keyandcableco/pr53_emu/captures/mapping.csv

bit | direction | label | A_l1 | A_l2 | B_l1 | B_l2 | A_ms | B_ms
C3:r3:c3 | ON | chord_root_C | ConcertGrand | 8 Beat | ConcertGrand | 8 Beat | 1469929982 | 1469985329
C3:r3:c4 | ON | chord_root_C | ConcertGrand | 8 Beat | ConcertGrand | 8 Beat | 1469929982 | 1469985329
C3:r0:c2 | OFF | chord_root_C | ConcertGrand | 8 Beat | ConcertGrand | 8 Beat | 1469929982 | 1469985329
C3:r1:c2 | OFF | chord_root_C | ConcertGrand | 8 Beat | ConcertGrand | 8 Beat | 1469929982 | 1469985329
C3:r1:c3 | OFF | chord_root_C | ConcertGrand | 8 Beat | ConcertGrand | 8 Beat | 1469929982 | 1469985329
C3:r1:c4 | OFF | chord_root_C | ConcertGrand | 8 Beat | ConcertGrand | 8 Beat | 1469929982 | 1469985329
C3:r4:c2 | OFF | chord_root_C | ConcertGrand | 8 Beat | ConcertGrand | 8 Beat | 1469929982 | 1469985329
C3:r4:c3 | OFF | chord_root_C | ConcertGrand | 8 Beat | ConcertGrand | 8 Beat | 1469929982 | 1469985329
C3:r4:c4 | OFF | chord_root_C | ConcertGrand | 8 Beat | ConcertGrand | 8 Beat | 1469929982 | 1469985329
C3:r7:c2 | OFF | chord_root_C | ConcertGrand | 8 Beat | ConcertGrand | 8 Beat | 1469929982 | 1469985329
C5:r0:c0 | ON | chord_root_C | ConcertGrand | 8 Beat | ConcertGrand | 8 Beat | 1470096539 | 1470109558
C5:r2:c0 | ON | chord_root_C | ConcertGrand | 8 Beat | ConcertGrand | 8 Beat | 1470096539 | 1470109558
C1:r7:c0 | ON | chord_root_C# | ConcertGrand | 8 Beat | ConcertGrand | 8 Beat | 1470109558 | 1470118982
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
C4:r4:c2 | OFF | rhythm_groups_gospel_blues | RHYTHM | Funk | RHYTHM | ChapelGospel | 1470387159 | 1470396660
C4:r4:c3 | OFF | rhythm_groups_gospel_blues | RHYTHM | Funk | RHYTHM | ChapelGospel | 1470387159 | 1470396660
C4:r4:c4 | OFF | rhythm_groups_gospel_blues | RHYTHM | Funk | RHYTHM | ChapelGospel | 1470387159 | 1470396660
C5:r0:c1 | OFF | rhythm_groups_gospel_blues | RHYTHM | Funk | RHYTHM | ChapelGospel | 1470387159 | 1470396660
C5:r0:c2 | OFF | rhythm_groups_gospel_blues | RHYTHM | Funk | RHYTHM | ChapelGospel | 1470387159 | 1470396660
C5:r1:c1 | OFF | rhythm_groups_gospel_blues | RHYTHM | Funk | RHYTHM | ChapelGospel | 1470387159 | 1470396660
C5:r1:c2 | OFF | rhythm_groups_gospel_blues | RHYTHM | Funk | RHYTHM | ChapelGospel | 1470387159 | 1470396660
C5:r2:c2 | OFF | rhythm_groups_gospel_blues | RHYTHM | Funk | RHYTHM | ChapelGospel | 1470387159 | 1470396660
C5:r3:c1 | OFF | rhythm_groups_gospel_blues | RHYTHM | Funk | RHYTHM | ChapelGospel | 1470387159 | 1470396660
C5:r3:c2 | OFF | rhythm_groups_gospel_blues | RHYTHM | Funk | RHYTHM | ChapelGospel | 1470387159 | 1470396660
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
