keyandcableco/pr53_emu/hardware/carrier/pr53_carrier.kicad_pcb

## KiCad design hardware/carrier/pr53_carrier.kicad_pcb (2026-10-31)

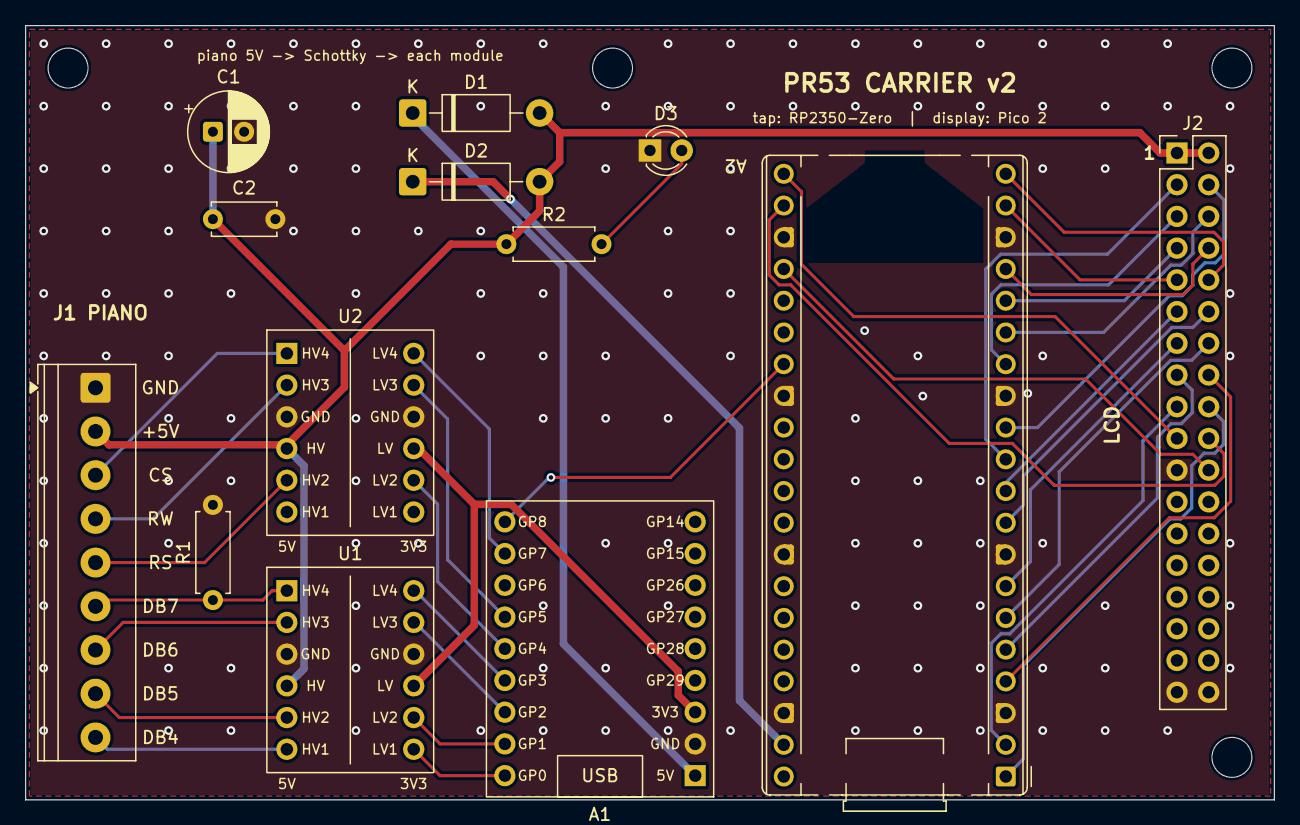
[picture p8: board pr53_carrier.kicad_pcb from above]

Board: 2 copper layers, 100.0 x 62.0 mm, 17 parts (0 on the bottom side), 40 nets.

Parts:
A1: RP2350-Zero (tap); RP2350-Zero_Socket
A2: Pico 2 (display); RaspberryPi_Pico_Common_THT
C1: 100u 10V; CP_Radial_D6.3mm_P2.50mm
C2: 100n; C_Disc_D5.0mm_W2.5mm_P5.00mm
D1, D2: 1N5819; D_DO-41_SOD81_P10.16mm_Horizontal
D3: PWR; LED_D3.0mm
H1, H2, H3, H4: M3; MountingHole_3.2mm_M3
J1: PR53_IN; TerminalBlock_Phoenix_PT-1,5-9-3.5-H_1x09_P3.50mm_Horizontal
J2: LCD_OUT (HiLetgo 36p); PinHeader_2x18_P2.54mm_Vertical
R1: 10k; R_Axial_DIN0207_L6.3mm_D2.5mm_P7.62mm_Horizontal
R2: 1k; R_Axial_DIN0207_L6.3mm_D2.5mm_P7.62mm_Horizontal
U1: BSS138_4ch (DB4-7); BSS138_4ch_Module
U2: BSS138_4ch (RS/RW/CS); BSS138_4ch_Module

Connections:
+3V3_TAP: A1.3, U1.4, U2.4
+5V: C1.1, C2.1, D1.2, D2.2, J1.2, J2.1, J2.2, R2.1, U1.10, U2.10
+5V_DISP: A2.39, D2.1
+5V_TAP: A1.1, D1.1
CS: J1.3, U2.7
DB4: J1.9, U1.12
DB5: J1.8, U1.11
DB6: J1.7, U1.8
DB7: J1.6, R1.1, U1.7
GND: A1.2, A2.3, A2.8, A2.13, A2.18, A2.23, A2.28, A2.33, A2.38, C1.2, C2.2, D3.1, J1.1, J2.21, J2.35, J2.36, R1.2, U1.3, U1.9, U2.3, U2.9
LCD_DB0: A2.1, J2.18
LCD_DB1: A2.2, J2.17
LCD_DB2: A2.4, J2.16
LCD_DB3: A2.5, J2.15
LCD_DB4: A2.6, J2.14
LCD_DB5: A2.7, J2.13
LCD_DB6: A2.9, J2.12
LCD_DB7: A2.10, J2.11
LCD_DB8: A2.11, J2.3
LCD_DB9: A2.12, J2.4
LCD_DB10: A2.14, J2.5
LCD_DB11: A2.15, J2.6
LCD_DB12: A2.16, J2.7
LCD_DB13: A2.17, J2.8
LCD_DB14: A2.19, J2.9
LCD_DB15: A2.20, J2.10
LCD_RS: A2.21, J2.19
LCD_RST: A2.24, J2.22
LCD_WR: A2.22, J2.20
LED_A: D3.2, R2.2
LINK: A1.18, A2.27
RS: J1.5, U2.11
RW: J1.4, U2.8
T_CS: A1.17, U2.1
T_DB4: A1.10, U1.6
T_DB5: A1.11, U1.5
T_DB6: A1.12, U1.2
T_DB7: A1.13, U1.1
T_RS: A1.14, U2.5
T_RW: A1.15, U2.2
