keyandcableco/pr53_emu/firmware/display/src/pr53_font.c

// pr53_font.c — 5x7 bitmap font + primitives, drawn via ili9488_fill_rect.
//
// A compact ASCII subset covers the labels, digits, and symbols the glass
// needs. Special codes: \x01 = quarter note, \x02 = down arrow.

#include "pr53_font.h"
#include "pr53_ili9486_par.h"
#include <string.h>

// 5x7 font, 5 columns per glyph, each column a 7-bit mask (LSB = top row).
// Only the characters we use are populated; others render blank.
typedef struct { char c; uint8_t col[5]; } Glyph;

static const Glyph FONT[] = {
    {' ', {0,0,0,0,0}},
    {'-', {0x08,0x08,0x08,0x08,0x08}},
    {'#', {0x14,0x7F,0x14,0x7F,0x14}},
    {'/', {0x60,0x10,0x08,0x04,0x03}},
    {'&', {0x36,0x49,0x55,0x22,0x50}},
    {'=', {0x14,0x14,0x14,0x14,0x14}},
    {'.', {0x00,0x60,0x60,0x00,0x00}},
    {'0', {0x3E,0x51,0x49,0x45,0x3E}},
    {'1', {0x00,0x42,0x7F,0x40,0x00}},
    {'2', {0x42,0x61,0x51,0x49,0x46}},
    {'3', {0x21,0x41,0x45,0x4B,0x31}},
    {'4', {0x18,0x14,0x12,0x7F,0x10}},
    {'5', {0x27,0x45,0x45,0x45,0x39}},
    {'6', {0x3C,0x4A,0x49,0x49,0x30}},
    {'7', {0x01,0x71,0x09,0x05,0x03}},
    {'8', {0x36,0x49,0x49,0x49,0x36}},
    {'9', {0x06,0x49,0x49,0x29,0x1E}},
    {'A', {0x7E,0x11,0x11,0x11,0x7E}},
    {'B', {0x7F,0x49,0x49,0x49,0x36}},
    {'C', {0x3E,0x41,0x41,0x41,0x22}},
    {'D', {0x7F,0x41,0x41,0x22,0x1C}},
    {'E', {0x7F,0x49,0x49,0x49,0x41}},
    {'F', {0x7F,0x09,0x09,0x09,0x01}},
    {'G', {0x3E,0x41,0x49,0x49,0x7A}},
    {'H', {0x7F,0x08,0x08,0x08,0x7F}},
    {'I', {0x00,0x41,0x7F,0x41,0x00}},
    {'J', {0x20,0x40,0x41,0x3F,0x01}},
    {'K', {0x7F,0x08,0x14,0x22,0x41}},
    {'L', {0x7F,0x40,0x40,0x40,0x40}},
    {'M', {0x7F,0x02,0x0C,0x02,0x7F}},
    {'N', {0x7F,0x04,0x08,0x10,0x7F}},
    {'O', {0x3E,0x41,0x41,0x41,0x3E}},
    {'P', {0x7F,0x09,0x09,0x09,0x06}},
    {'Q', {0x3E,0x41,0x51,0x21,0x5E}},
    {'R', {0x7F,0x09,0x19,0x29,0x46}},
    {'S', {0x46,0x49,0x49,0x49,0x31}},
    {'T', {0x01,0x01,0x7F,0x01,0x01}},
    {'U', {0x3F,0x40,0x40,0x40,0x3F}},
    {'V', {0x1F,0x20,0x40,0x20,0x1F}},
    {'W', {0x7F,0x20,0x18,0x20,0x7F}},
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
    // lowercase (full set for voice/rhythm names)
    {'a', {0x20,0x54,0x54,0x54,0x78}},
    {'b', {0x7F,0x48,0x44,0x44,0x38}},
    {'c', {0x38,0x44,0x44,0x44,0x20}},
    {'d', {0x38,0x44,0x44,0x48,0x7F}},
    {'e', {0x38,0x54,0x54,0x54,0x18}},
    {'f', {0x08,0x7E,0x09,0x01,0x02}},
    {'g', {0x0C,0x52,0x52,0x52,0x3E}},
    {'h', {0x7F,0x08,0x04,0x04,0x78}},
    {'i', {0x00,0x44,0x7D,0x40,0x00}},
    {'j', {0x20,0x40,0x44,0x3D,0x00}},
    {'k', {0x7F,0x10,0x28,0x44,0x00}},
    {'l', {0x00,0x41,0x7F,0x40,0x00}},
    {'m', {0x7C,0x04,0x18,0x04,0x78}},
    {'n', {0x7C,0x08,0x04,0x04,0x78}},
    {'o', {0x38,0x44,0x44,0x44,0x38}},
    {'p', {0x7C,0x14,0x14,0x14,0x08}},
    {'q', {0x08,0x14,0x14,0x18,0x7C}},
    {'r', {0x7C,0x08,0x04,0x04,0x08}},
    {'s', {0x48,0x54,0x54,0x54,0x20}},
    {'t', {0x04,0x3F,0x44,0x40,0x20}},
    {'u', {0x3C,0x40,0x40,0x20,0x7C}},
    {'v', {0x1C,0x20,0x40,0x20,0x1C}},
    {'w', {0x3C,0x40,0x30,0x40,0x3C}},
    {'x', {0x44,0x28,0x10,0x28,0x44}},
    {'y', {0x0C,0x50,0x50,0x50,0x3C}},
    {'z', {0x44,0x64,0x54,0x4C,0x44}},
    // symbols
    {'\x01', {0x08,0x7C,0x08,0x00,0x00}},  // quarter note (approx)
    {'\x02', {0x04,0x02,0x7F,0x02,0x04}},  // down arrow (approx)
};

static const Glyph *find_glyph(char c) {
    for (size_t i = 0; i < sizeof(FONT)/sizeof(FONT[0]); i++)
        if (FONT[i].c == c) return &FONT[i];
    return &FONT[0]; // space
}

static int glyph_w(int scale) { return (5 + 1) * scale; } // 5 cols + 1 space

static void draw_glyph(int x, int y, const Glyph *g, int scale, uint16_t color) {
    for (int cx = 0; cx < 5; cx++) {
        uint8_t colbits = g->col[cx];
        for (int ry = 0; ry < 7; ry++) {
            if (colbits & (1 << ry)) {
                ili9488_fill_rect(x + cx*scale, y + ry*scale, scale, scale, color);
            }
        }
    }
}

void font_text(int x, int y, const char *s, int scale, uint16_t color) {
    int cx = x;
    for (; *s; s++) {
        draw_glyph(cx, y, find_glyph(*s), scale, color);
        cx += glyph_w(scale);
    }
}

// Same layout as font_text, but each pixel is a separate dot with a 1 px gap,
// like the original LCD's dot-matrix characters. scale must be 2 or more.
void font_text_dots(int x, int y, const char *s, int scale, uint16_t color) {
    int cx = x;
    for (; *s; s++) {
        const Glyph *g = find_glyph(*s);
        for (int col = 0; col < 5; col++)
            for (int ry = 0; ry < 7; ry++)
                if (g->col[col] & (1 << ry))
                    ili9488_fill_rect(cx + col*scale, y + ry*scale, scale - 1, scale - 1, color);
        cx += glyph_w(scale);
    }
}

static int text_px_w(const char *s, int scale) {
    return (int)strlen(s) * glyph_w(scale);
}

void font_text_centered(int cx, int y, const char *s, int scale, uint16_t color) {
    font_text(cx - text_px_w(s, scale)/2, y, s, scale, color);
}

void font_itoa(char *buf, int v) {
    if (v == 0) { buf[0] = '0'; buf[1] = 0; return; }
    char tmp[12]; int n = 0, neg = 0;
    if (v < 0) { neg = 1; v = -v; }
    while (v) { tmp[n++] = '0' + v % 10; v /= 10; }
    int i = 0;
    if (neg) buf[i++] = '-';
    while (n) buf[i++] = tmp[--n];
    buf[i] = 0;
}

void font_box(int x, int y, int w, int h, uint16_t color) {
    ili9488_fill_rect(x, y, w, 1, color);
    ili9488_fill_rect(x, y + h - 1, w, 1, color);
    ili9488_fill_rect(x, y, 1, h, color);
    ili9488_fill_rect(x + w - 1, y, 1, h, color);
}

void font_kbd_icon(int x, int y, uint16_t color) {
    // a keyboard: outline, white-key dividers, short black keys
    font_box(x, y, 30, 18, color);
    for (int i = 1; i < 5; i++)
        ili9488_fill_rect(x + i*6, y, 1, 18, color);
    for (int i = 0; i < 5; i++)
        if (i != 2) ili9488_fill_rect(x + 4 + i*6, y + 1, 3, 9, color);
}

void font_drum_icon(int x, int y, uint16_t color) {
    // a drum kit: bass drum, two cymbals on stands, a snare
    font_box(x + 6, y + 8, 14, 10, color);              // bass drum
    ili9488_fill_rect(x + 11, y + 11, 4, 4, color);
    ili9488_fill_rect(x, y + 3, 8, 1, color);            // left cymbal + stand
    ili9488_fill_rect(x + 3, y + 3, 1, 15, color);
    ili9488_fill_rect(x + 19, y + 1, 8, 1, color);       // right cymbal + stand
    ili9488_fill_rect(x + 23, y + 1, 1, 17, color);
    font_box(x + 1, y + 10, 5, 4, color);                // snare
}
