keyandcableco/pr53_emu/(commit log)

2026-07-31 Initial commit: SX-PR53 LCD emulator
    [capture.csv, mapping.csv, tempo_learned.csv]
2026-08-01 Major updates, display working 80%
    [mapping.csv, tempo_learned.csv]
2026-10-07 PR53 display firmware: the C port on a Pico 2 driving a 3.5" panel
    pr53_fw is the Python display emulator ported to C for an RP2350, drawing
    the PR53's display on a HiLetgo 3.5" ILI9486/ILI9488 16-bit parallel panel.
    Core 0 decodes the HD44780 accesses, core 1 renders three zones with
    per-field dirty tracking. The bus arrives from the existing v15 tap Pico
    over a one-way UART link (bus_tap.c). host.mk builds the decode and render
    logic on a PC and runs the pipeline against a captured session log.
2026-10-31 Bring the whole PR53 project into one repo
    Everything for the SX-PR53 display replacement now lives here, laid out
    by part:
    - firmware/tap: the v16 tap firmware for the RP2350-Zero (adds the UART
    link to the display Pico and answers the piano's reads)
    - firmware/display: the display firmware for the Pico 2 (was pr53_fw/)
    - tools: the Python tools (was python/)
    - captures: the bus logs, plus a full start-up captured on 2026-10-31
    - hardware/carrier: the PR53 carrier v2 board with its generators,
    Gerbers and bring-up notes; rev1/ is the first fab
    - hardware/archive: earlier perfboard maps and board plans
    - docs/piano-interface.md: CN1 pinout, the bus, busy flag and power
    Both firmwares n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
2026-10-31 Fix stale comments and the tap's start-up banner
    The tap's header comment still described v15, its banner said the
    display link was on GP0 (it's GP8), and DISP_BAUD was defined twice. The
    display's main.c still described bus_tap.c as a stub to replace; it's the
    real UART receiver.
    Comment and string changes only: the display UF2 is byte-identical, and
    the tap UF2 differs in one byte, the banner's pin number.
2026-10-31 Add the LCD test-mode capture
    Holding G4 + G5 at power-on enters the service manual's LCD check: every
    CGRAM pixel lit, then the character set scrolled one code every ~3 s.
    The capture gives the full set of glass segments (all 320 CGRAM bits) and
    the character codes the piano can print, including codes above 0x7F that
    the display firmware's font doesn't draw yet.
2026-10-31 Map the whole front panel: inventory and guided campaigns
    docs/front-panel.md lists every control on the SX-PR53's panel by section
    (from photos of the piano), every display field with its decode status,
    and the service manual's power-on test modes.
    pr53_campaign.py gets one campaign per panel section, built from a single
    control list (163 steps in all), plus chord_roots_all12 for the root
    letters and sharps. SET and RECORD / EASY REC are left out so the owner's
    stored data can't be overwritten while mapping.
2026-10-31 Tighten the chord/tempo decode after review
    - Tempo hundreds: decode the column as-is first, and only ignore the
    flat/sharp row when that doesn't give a digit, so a full-shape "2" still
    reads (no flat/sharp combination looks like a digit).
    - Drop the two unmeasured letter guesses from the C table (all segments
    as "A", a-f as "B"). C and Python now agree; an all-lit frame shows no
    chord instead of "A#".
    - test_chords requires all 12 roots, so a cut-short run fails.
    - Zero-initialise the chord buffer in pr53_decode_all.
2026-10-31 Display: layout after the original glass, menus no longer freeze, colours
    - New layout following the printed frame of the original SX-PR53 glass:
    TEMPO, CHORD and PAGE/TRANSPOSE boxes on top, the two text lines large
    in one box with the small readouts to their left, the part meters
    between two dotted rules. Tempo and readouts are 7-segment digits with
    faint ghost segments; the always-on RIGHT 1/RHYTHM labels, icons and
    wrong-way arrows are gone, and the text lines are aligned again.
    - Menus are written without a DISP_CTRL afterwards, so the screen stayed
    on the previous view. Writes followed by 30 ms of quiet on the link are
    now published too (bus_get_byte_timeout, SETTLE_US).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
2026-10-31 Add the display-sniffer feasibility study
    Could the PR53 tap and display pair sniff other vintage keyboards'
    displays? A survey of 1980-2005 display interfaces with sourced examples,
    what the v2 carrier and v16 tap handle as-is, what the bring-up problems
    imply, output options, and a staged v3 plan with effort estimates.
2026-10-31 Display: settle after 60 ms, one rule between PAGE and TRANSPOSE
    Review measured gaps inside one piano update of up to 30 ms (and 76 ms
    once in the LCD test mode), so 30 ms could publish a half-written frame.
    Real pauses after pending writes are all at least ~105 ms, the piano's
    refresh tick; 60 ms sits between the two. Same value in the preview.
    The PAGE and TRANSPOSE boxes now share their dividing line instead of
    drawing two. Also commits the campaign log as it stands.
2026-10-31 Decode every part number and meter; swap red and blue in software
    Part numbers, worked out from the "bargraph min max" volume sweeps in
    session_071830 and checked against the photo of the original glass
    (118 113 113 113 118 113 100 127):
    - P1-P5: the hundreds place is a lone "1", one bit in row 6 of C1
    (P1 c2, P2 c1) and C3 (P3 c4, P4 c3, P5 c2).
    - P6-P8 sit in C2/C3, whose digits put d on row 7 like the tempo, with a
    full hundreds digit (so "---" when off): P6 C3 c4/c3/c2, P7 C2 c4 +
    C3 c0/c1, P8 C2 c2/c3/c1. The retry-with-d hack is gone.
    - P6-P8 meters fill rows 6..2; row 7 stays lit at any level.
    C and Python decoders agree frame for frame on three captures. New host
    test test_numb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
2026-10-31 Display: set the panel's power, VCOM and gamma; no byte swap
    The colour test screen showed the real fault: with the chip's default
    power and gamma settings the panel's response isn't monotonic (a value of 1
    lit brighter than 16, full red came out dim), so no colour mapping could
    look right. The driver now sends MCUFRIEND_kbv's ILI9486 set-up (power
    control, VCOM, inversion control, display function, gamma set 4) in the
    library's order, then inversion off.
    The same screen showed bus bits 0-4 as red, 5-10 green, 11-15 blue: no
    byte swap, red and blue swapped. THEME_SWAP_BYTES is now 0.
    test_numbers checks the campaign log only up to its last note; the log
    keeps recording free play afterwards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
2026-11-01 Tap v17: answer reads with the live address counter
    The piano reads the address counter back while writing text. v16 kept two
    answers queued ahead in PIO1's TX FIFO, so every read got one computed a
    read or two earlier. The capture shows what followed: 39 line writes cut
    short today and finished seconds later (median 4 s), or minutes later when
    nothing else prompted the piano (line 2 stuck on "SX-PR53" for 12 minutes
    after a restart; menus as "MEM&CONTRO", "Part Setti").
    Core 1 now replaces the queued answer the moment a write changes the
    address, so at most one answer is queued and it's the live one. The read
    responder and capture also start before the 3 s wait for USB (the README's
    known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
2026-11-01 Tap v17: start without waiting for USB; banner and header
    From review: with capture now starting first, the 3 s wait for a USB host
    only held writes in the ring and then sent them to the display in a burst
    it partly skips. The wait existed for the banner, so it's gone: the ring
    drains and feeds the display from the start, and the banner reaches only a
    host already listening. CMake header says v17; banner no longer says to
    power-cycle the piano.
2026-11-01 Add a product plan for a general display sniffer board
    One RP2350B (PGA2350 for prototypes) behind an SN74LVC16T245, a keyed
    26-pin connector with per-instrument adapters, analog inputs for supply
    and contrast, an SPI TFT and microSD, in an optional enclosure. Covers
    every display type from the feasibility study, with passive and replace
    modes, an interlock, protection, power budget, phases, costs and risks.
2026-11-01 Show a Key & Cable Co. start-up screen in place of the piano's boot screen
    The display Pico draws the Key & Cable Co. logo as soon as the panel is up,
    with "Technics / SX-PR53", "LCD replacement", a QR code and keyandcable.com
    beside it, in the glass palette. It holds through the piano's blank and
    "Technics / SX-PR53" frames and hands back on the first other frame with a
    full repaint (render_static + render_frame); a 30 s limit covers a piano
    that never gets past its start-up. If the piano restarts while the display
    stays on, it comes back for the "Technics" screen. Only core 1 changes;
    decoding and the tap are untouched. THEME_SPLASH 0 turns it off,
    THEME_SPLASH_QR 0 drops the QR code.
    The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
2026-11-03 Show the start-up logo on every piano restart, ALL INITIAL ones too
    With the carrier on USB the display stays on while the piano restarts, and
    the logo came back only with the piano's "Technics" screen. When the piano
    initialises its settings it starts on "ALL INITIAL" instead, so Greg saw no
    logo on those restarts.
    The decoder now counts CLEAR commands (DisplayState.piano_starts). The
    piano sends CLEAR only while setting up its LCD at start-up: all 11 in the
    captures sit in that set-up. A new count brings the logo back; it holds
    through the blank frames (the CLEAR frame still has the old tempo and
    meters, blanked a few ms later) and "Technics", and hands back on the next
    real screen as bef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
